Dante-B-777/LitterBot/docs/superpowers/plans/2026-04-07-sensor-ui.md

# Sensor UI Integration Implementation Plan

> **For agentic workers:** REQUIRED SUB-SKILL: Use superpowers:subagent-driven-development (recommended) or superpowers:executing-plans to implement this plan task-by-task. Steps use checkbox (`- [ ]`) syntax for tracking.

**Goal:** Wire RPLidar `/scan` and RealSense `/camera/color/image_raw` into the existing UI — live camera feed in `camera-panel`, status dots for both sensors, and scan metadata in `lidar-panel`.

**Architecture:** Subscribe to `/scan` and `/camera/color/image_raw` in `ui_server.py` (the existing ROS2 node that already bridges topics to the browser WebSocket). Add two new WebSocket message types: `sensor_status` (for lidar heartbeat + scan stats) and `cam_frame` (base64-JPEG camera frame). The frontend handles both types to update status dots and panels. No new ROS2 nodes needed — this is additive to `ui_server.py`.

**Tech Stack:** Python `sensor_msgs/LaserScan`, `sensor_msgs/Image`, Pillow (PIL) for JPEG encoding, numpy for image array conversion, existing FastAPI/WebSocket infrastructure, rplidar_ros, realsense2_camera.

> **Scope note:** LiDAR (Tasks 1–3) and Camera (Tasks 4–6) are fully independent. Either section can be executed alone without the other.

---

## File Map

| File | Action | Responsibility |
|---|---|---|
| `ros2/litterbot_bridge/litterbot_bridge/ui_server.py` | Modify | Add `/scan` + `/camera/color/image_raw` subscribers, throttled broadcasts, `_encode_image()` + `_summarize_scan()` helpers |
| `ros2/litterbot_bridge/litterbot_bridge/ui/index.html` | Modify | Handle `sensor_status` + `cam_frame` WS messages; update `updateDots()`; populate `lidar-panel` + `camera-panel` |
| `ros2/litterbot_bridge/launch/litterbot.launch.py` | Modify | Add rplidar_ros + realsense2_camera nodes behind `mock_lidar` / `mock_camera` flags |
| `ros2/litterbot_bridge/requirements.txt` | Modify | Add `Pillow>=9.0.0` and `numpy>=1.21.0` |
| `ros2/litterbot_bridge/test/test_sensor_ui.py` | Create | Unit tests for `_summarize_scan` and `_encode_image` helpers |

---

## WebSocket Protocol Additions

```
Server -> Browser (lidar heartbeat, ~1 Hz):
  {"type": "sensor_status", "sensor": "lidar", "ts": 1234.56,
   "count": 360, "range_min": 0.15, "range_max": 3.4}

Server -> Browser (camera frame, ~10 fps):
  {"type": "cam_frame", "data": "<base64_jpeg>", "ts": 1234.56}
```

---

## Task 1: Add `_summarize_scan` helper and `/scan` subscriber

**Files:**
- Modify: `ros2/litterbot_bridge/litterbot_bridge/ui_server.py`
- Create: `ros2/litterbot_bridge/test/test_sensor_ui.py`

- [ ] **Step 1: Write the failing test**

```python
# ros2/litterbot_bridge/test/test_sensor_ui.py
"""
test_sensor_ui.py — Pure logic tests for sensor UI helpers in ui_server.

No ROS2 runtime needed — tests the static helper methods directly.

Run with:
    pytest test/test_sensor_ui.py -v
"""
import sys, os
sys.path.insert(0, os.path.join(os.path.dirname(__file__), '..'))

from unittest.mock import MagicMock

# ---------------------------------------------------------------------------
# _summarize_scan tests
# ---------------------------------------------------------------------------

def _make_scan(ranges, range_min=0.15, range_max=12.0):
    """Build a minimal mock LaserScan for testing."""
    msg = MagicMock()
    import math
    msg.ranges = [r for r in ranges]  # list of floats
    msg.range_min = range_min
    msg.range_max = range_max
    return msg

def test_summarize_scan_valid_count():
    """Valid ranges within [range_min, range_max] are counted correctly."""
    from litterbot_bridge.ui_server import UIServer
    msg = _make_scan([0.5, 1.0, 12.0, float('inf'), 0.1])  # 0.1 < range_min, inf invalid
    result = UIServer._summarize_scan(msg)
    assert result['count'] == 3, f"Expected 3 valid ranges, got {result['count']}"

def test_summarize_scan_min_max():
    """Reported min/max reflect only valid readings."""
    from litterbot_bridge.ui_server import UIServer
    msg = _make_scan([1.0, 3.5, float('inf'), 0.1])
    result = UIServer._summarize_scan(msg)
    assert abs(result['range_min'] - 1.0) < 0.001
    assert abs(result['range_max'] - 3.5) < 0.001

def test_summarize_scan_all_invalid():
    """All-invalid scan returns zeros without crashing."""
    from litterbot_bridge.ui_server import UIServer
    msg = _make_scan([float('inf'), float('nan')])
    result = UIServer._summarize_scan(msg)
    assert result['count'] == 0
    assert result['range_min'] == 0.0
    assert result['range_max'] == 0.0
```

- [ ] **Step 2: Run test to verify it fails**

```bash
cd /mnt/c/Users/benji/Documents/GitHub/LitterBot_STM32/ros2/litterbot_bridge
python3 -m pytest test/test_sensor_ui.py -v
```

Expected: `ImportError` or `AttributeError` — `UIServer` has no `_summarize_scan`.

- [ ] **Step 3: Add `_summarize_scan` to `ui_server.py`**

Add this import at the top of `ui_server.py` with the other imports:
```python
import math
from sensor_msgs.msg import Image, LaserScan
```

Add this static method to the `UIServer` class (after `_on_odom`, before the asyncio helpers):
```python
    @staticmethod
    def _summarize_scan(msg: LaserScan) -> dict:
        """Extract valid range stats from a LaserScan message."""
        valid = [r for r in msg.ranges
                 if math.isfinite(r) and msg.range_min <= r <= msg.range_max]
        return {
            'count':     len(valid),
            'range_min': round(min(valid), 3) if valid else 0.0,
            'range_max': round(max(valid), 3) if valid else 0.0,
        }
```

- [ ] **Step 4: Run tests to verify they pass**

```bash
cd /mnt/c/Users/benji/Documents/GitHub/LitterBot_STM32/ros2/litterbot_bridge
python3 -m pytest test/test_sensor_ui.py::test_summarize_scan_valid_count test/test_sensor_ui.py::test_summarize_scan_min_max test/test_sensor_ui.py::test_summarize_scan_all_invalid -v
```

Expected: 3 PASS.

- [ ] **Step 5: Add `_last_scan_time`, `_last_scan_broadcast`, and `/scan` subscriber to `UIServer.__init__`**

In `UIServer.__init__`, after the `self._dev_mode` line (around line 145), add:
```python
        # ------------------------------------------------------------------ #
        # Sensor status tracking
        # ------------------------------------------------------------------ #
        self._last_scan_time: float = 0.0       # time of last /scan message
        self._last_scan_broadcast: float = 0.0  # time of last WS broadcast
        self._last_cam_time: float = 0.0        # time of last image message
        self._last_cam_broadcast: float = 0.0   # time of last cam_frame WS broadcast
```

At the end of the subscribers block (after the `/odom` subscription), add:
```python
        self.create_subscription(LaserScan, '/scan',                     self._on_scan,  10)
```

- [ ] **Step 6: Add `_on_scan` callback**

Add this method to `UIServer` after `_on_odom`:
```python
    def _on_scan(self, msg: LaserScan) -> None:
        """Track LiDAR heartbeat and broadcast scan stats at ~1 Hz."""
        now = time.time()
        self._last_scan_time = now
        # Throttle WebSocket broadcasts to 1 Hz
        if now - self._last_scan_broadcast < 1.0:
            return
        self._last_scan_broadcast = now
        stats = self._summarize_scan(msg)
        payload = {
            "type":      "sensor_status",
            "sensor":    "lidar",
            "ts":        now,
            "count":     stats['count'],
            "range_min": stats['range_min'],
            "range_max": stats['range_max'],
        }
        self._loop.call_soon_threadsafe(self._broadcast_dict_sync, payload)
```

- [ ] **Step 7: Commit**

```bash
cd /mnt/c/Users/benji/Documents/GitHub/LitterBot_STM32
git add ros2/litterbot_bridge/litterbot_bridge/ui_server.py \
        ros2/litterbot_bridge/test/test_sensor_ui.py
git commit -m "feat: add _summarize_scan helper and /scan subscriber to ui_server"
```

---

## Task 2: Wire lidar status dot and panel in `index.html`

**Files:**
- Modify: `ros2/litterbot_bridge/litterbot_bridge/ui/index.html`

- [ ] **Step 1: Add `lastScanTime` tracking to the `ws.onmessage` handler**

In `index.html`, find the `ws.onmessage` handler. It currently has an `if (data.type === 'log')` block and an `if (data.type === 'state')` block. After the existing blocks, add:

```javascript
        if (data.type === 'sensor_status' && data.sensor === 'lidar') {
          lastScanTime = data.ts;
          const panel = document.getElementById('lidar-panel');
          if (panel) {
            panel.textContent =
              `LiDAR — ${data.count} pts | ${data.range_min}m – ${data.range_max}m`;
          }
        }
```

- [ ] **Step 2: Update `updateDots()` for `dot-lidar`**

Find line:
```javascript
  setDot('dot-lidar', null);  // not connected yet — wired up when rplidar_ros is added
```

Replace with:
```javascript
  const scanAge = now - lastScanTime;
  setDot('dot-lidar', lastScanTime === 0 ? null :
                      scanAge < 5  ? 'green' :
                      scanAge < 30 ? 'yellow' : 'red');
```

- [ ] **Step 3: Update `lidar-panel` CSS to allow text**

Find in the CSS:
```css
  #lidar-panel {
    flex: 1;
    display: flex;
    align-items: center;
    justify-content: center;
    background: #111;
    border-bottom: 1px solid #2a2a2a;
    color: #333;
    font-size: 13px;
    letter-spacing: 0.05em;
  }
```

Change `color: #333;` to `color: #aaa;` so the text is visible when connected:
```css
  #lidar-panel {
    flex: 1;
    display: flex;
    align-items: center;
    justify-content: center;
    background: #111;
    border-bottom: 1px solid #2a2a2a;
    color: #aaa;
    font-size: 13px;
    letter-spacing: 0.05em;
  }
```

- [ ] **Step 4: Verify manually**

Start the ROS2 stack in mock mode:
```bash
cd ~/litterbot_ws && source install/setup.bash
ros2 launch litterbot_bridge litterbot.launch.py
```

Open `http://localhost:8765`. The `dot-lidar` should remain gray (no scan data in mock mode). That is correct behavior.

To verify the dot goes green: in a second terminal, publish a fake scan:
```bash
source ~/litterbot_ws/install/setup.bash
ros2 topic pub --once /scan sensor_msgs/msg/LaserScan \
  '{header: {frame_id: "laser"}, range_min: 0.15, range_max: 12.0,
    angle_min: -3.14, angle_max: 3.14, angle_increment: 0.017,
    ranges: [1.0, 2.0, 3.0, 1.5, 0.5]}'
```

`dot-lidar` should turn green and `lidar-panel` should update.

- [ ] **Step 5: Commit**

```bash
cd /mnt/c/Users/benji/Documents/GitHub/LitterBot_STM32
git add ros2/litterbot_bridge/litterbot_bridge/ui/index.html
git commit -m "feat: wire dot-lidar and lidar-panel to /scan sensor_status messages"
```

---

## Task 3: Add rplidar_ros to launch file

**Files:**
- Modify: `ros2/litterbot_bridge/launch/litterbot.launch.py`

- [ ] **Step 1: Update launch file**

Replace the entire contents of `launch/litterbot.launch.py` with:

```python
"""
litterbot.launch.py — Start all LitterBot ROS2 nodes with one command.

Usage:
    ros2 launch litterbot_bridge litterbot.launch.py

    # Real hardware:
    ros2 launch litterbot_bridge litterbot.launch.py mock_serial:=false serial_port:=/dev/ttyACM0

    # With LiDAR:
    ros2 launch litterbot_bridge litterbot.launch.py mock_lidar:=false lidar_port:=/dev/ttyUSB0

    # With camera:
    ros2 launch litterbot_bridge litterbot.launch.py mock_camera:=false
"""
from launch import LaunchDescription
from launch.actions import DeclareLaunchArgument
from launch.conditions import UnlessCondition
from launch.substitutions import LaunchConfiguration
from launch_ros.actions import Node

def generate_launch_description() -> LaunchDescription:
    return LaunchDescription([
        DeclareLaunchArgument('serial_port',  default_value='/dev/ttyACM0'),
        DeclareLaunchArgument('mock_serial',  default_value='true'),
        DeclareLaunchArgument('ui_port',      default_value='8765'),
        DeclareLaunchArgument('mock_lidar',   default_value='true'),
        DeclareLaunchArgument('lidar_port',   default_value='/dev/ttyUSB0'),
        DeclareLaunchArgument('mock_camera',  default_value='true'),

        Node(
            package='litterbot_bridge',
            executable='stm32_bridge',
            name='stm32_bridge',
            parameters=[{
                'serial_port': LaunchConfiguration('serial_port'),
                'mock_serial':  LaunchConfiguration('mock_serial'),
            }],
            output='screen',
        ),

        Node(
            package='litterbot_bridge',
            executable='ui_server',
            name='ui_server',
            parameters=[{
                'port': LaunchConfiguration('ui_port'),
            }],
            output='screen',
        ),

        # RPLidar — only started when mock_lidar:=false
        Node(
            package='rplidar_ros',
            executable='rplidar_composition',
            name='rplidar',
            parameters=[{
                'serial_port':     LaunchConfiguration('lidar_port'),
                'serial_baudrate': 115200,
                'frame_id':        'laser',
                'angle_compensate': True,
            }],
            output='screen',
            condition=UnlessCondition(LaunchConfiguration('mock_lidar')),
        ),

        # RealSense — only started when mock_camera:=false
        Node(
            package='realsense2_camera',
            executable='realsense2_camera_node',
            name='camera',
            parameters=[{
                'enable_color': True,
                'enable_depth': False,
                'color_width':  640,
                'color_height': 480,
                'color_fps':    15,
            }],
            output='screen',
            condition=UnlessCondition(LaunchConfiguration('mock_camera')),
        ),
    ])
```

- [ ] **Step 2: Verify launch file still works in mock mode**

```bash
cd ~/litterbot_ws && colcon build --packages-select litterbot_bridge && source install/setup.bash
ros2 launch litterbot_bridge litterbot.launch.py
```

Expected: starts without error, `stm32_bridge` and `ui_server` nodes appear. rplidar and camera nodes do NOT start (mock mode).

- [ ] **Step 3: Commit**

```bash
cd /mnt/c/Users/benji/Documents/GitHub/LitterBot_STM32
git add ros2/litterbot_bridge/launch/litterbot.launch.py
git commit -m "feat: add rplidar_ros and realsense2_camera to launch file behind mock flags"
```

---

## Task 4: Add `_encode_image` helper and `/camera/color/image_raw` subscriber

**Files:**
- Modify: `ros2/litterbot_bridge/litterbot_bridge/ui_server.py`
- Modify: `ros2/litterbot_bridge/requirements.txt`
- Modify: `ros2/litterbot_bridge/test/test_sensor_ui.py`

- [ ] **Step 1: Add Pillow + numpy to requirements.txt**

Replace the entire file:
```
fastapi>=0.110.0
uvicorn[standard]>=0.29.0
Pillow>=9.0.0
numpy>=1.21.0
```

Install:
```bash
pip install Pillow numpy
```

- [ ] **Step 2: Write the failing test**

Add to `test/test_sensor_ui.py`:

```python
# ---------------------------------------------------------------------------
# _encode_image tests
# ---------------------------------------------------------------------------

def _make_image_msg(width=4, height=4, encoding='rgb8'):
    """Build a minimal mock sensor_msgs/Image for testing."""
    import numpy as np
    msg = MagicMock()
    msg.width    = width
    msg.height   = height
    msg.encoding = encoding
    msg.step     = width * 3
    # Flat RGB bytes: 4x4 solid red image
    arr = np.zeros((height, width, 3), dtype=np.uint8)
    arr[:, :, 0] = 255  # red channel
    msg.data = arr.tobytes()
    return msg

def test_encode_image_returns_string():
    """_encode_image returns a non-empty base64 string for valid rgb8 input."""
    from litterbot_bridge.ui_server import UIServer
    msg = _make_image_msg(encoding='rgb8')
    result = UIServer._encode_image(msg)
    assert isinstance(result, str)
    assert len(result) > 0

def test_encode_image_is_valid_base64():
    """Output is valid base64 that decodes without error."""
    import base64
    from litterbot_bridge.ui_server import UIServer
    msg = _make_image_msg(encoding='rgb8')
    result = UIServer._encode_image(msg)
    decoded = base64.b64decode(result)  # raises on bad base64
    assert len(decoded) > 0

def test_encode_image_bgr8_does_not_crash():
    """bgr8 encoding is accepted (channels swapped before JPEG encode)."""
    from litterbot_bridge.ui_server import UIServer
    msg = _make_image_msg(encoding='bgr8')
    result = UIServer._encode_image(msg)
    assert isinstance(result, str) and len(result) > 0

def test_encode_image_unknown_encoding_returns_none():
    """Unsupported encoding returns None without raising."""
    from litterbot_bridge.ui_server import UIServer
    msg = _make_image_msg(encoding='yuv422')
    result = UIServer._encode_image(msg)
    assert result is None
```

- [ ] **Step 3: Run tests to verify they fail**

```bash
cd /mnt/c/Users/benji/Documents/GitHub/LitterBot_STM32/ros2/litterbot_bridge
python3 -m pytest test/test_sensor_ui.py -k "encode_image" -v
```

Expected: `AttributeError` — `UIServer` has no `_encode_image`.

- [ ] **Step 4: Add `_encode_image` to `ui_server.py`**

Add these imports at the top of `ui_server.py` with the existing imports:
```python
import base64
import io

import numpy as np
from PIL import Image as PILImage
from sensor_msgs.msg import Image, LaserScan
```

Add this static method to `UIServer` (after `_summarize_scan`):
```python
    @staticmethod
    def _encode_image(msg: Image) -> str | None:
        """
        Convert a sensor_msgs/Image to a base64-encoded JPEG string.

        Supports rgb8 and bgr8 encodings. Returns None for unsupported encodings.
        """
        if msg.encoding not in ('rgb8', 'bgr8'):
            return None
        try:
            arr = np.frombuffer(bytes(msg.data), dtype=np.uint8).reshape(
                msg.height, msg.width, 3
            )
            if msg.encoding == 'bgr8':
                arr = arr[:, :, ::-1]  # BGR -> RGB
            buf = io.BytesIO()
            PILImage.fromarray(arr, 'RGB').save(buf, format='JPEG', quality=70)
            return base64.b64encode(buf.getvalue()).decode('ascii')
        except Exception:
            return None
```

- [ ] **Step 5: Run tests to verify they pass**

```bash
cd /mnt/c/Users/benji/Documents/GitHub/LitterBot_STM32/ros2/litterbot_bridge
python3 -m pytest test/test_sensor_ui.py -k "encode_image" -v
```

Expected: 4 PASS.

- [ ] **Step 6: Add `/camera/color/image_raw` subscriber to `UIServer.__init__`**

After the `/scan` subscription line, add:
```python
        self.create_subscription(Image,     '/camera/color/image_raw', self._on_image, 1)
```

Note: queue depth 1 — we don't want a backlog of frames; always process the latest.

- [ ] **Step 7: Add `_on_image` callback**

Add after `_on_scan`:
```python
    def _on_image(self, msg: Image) -> None:
        """Convert incoming camera frame to JPEG and broadcast at ~10 fps."""
        now = time.time()
        self._last_cam_time = now
        # Throttle to ~10 fps
        if now - self._last_cam_broadcast < 0.1:
            return
        self._last_cam_broadcast = now
        frame_b64 = self._encode_image(msg)
        if frame_b64 is None:
            return
        payload = {
            "type": "cam_frame",
            "data": frame_b64,
            "ts":   now,
        }
        self._loop.call_soon_threadsafe(self._broadcast_dict_sync, payload)
```

- [ ] **Step 8: Run all sensor tests**

```bash
cd /mnt/c/Users/benji/Documents/GitHub/LitterBot_STM32/ros2/litterbot_bridge
python3 -m pytest test/test_sensor_ui.py -v
```

Expected: all 7 tests PASS.

- [ ] **Step 9: Commit**

```bash
cd /mnt/c/Users/benji/Documents/GitHub/LitterBot_STM32
git add ros2/litterbot_bridge/litterbot_bridge/ui_server.py \
        ros2/litterbot_bridge/requirements.txt \
        ros2/litterbot_bridge/test/test_sensor_ui.py
git commit -m "feat: add _encode_image helper and /camera/color/image_raw subscriber"
```

---

## Task 5: Wire camera display in `index.html`

**Files:**
- Modify: `ros2/litterbot_bridge/litterbot_bridge/ui/index.html`

- [ ] **Step 1: Add `lastCamTime` variable**

Find the existing sensor time variables near line 686:
```javascript
let lastStm32TxTime = 0;
let lastOdomTime    = 0;
let lastScanTime    = 0;  // populated when /scan topic is wired up
```

Add:
```javascript
let lastStm32TxTime = 0;
let lastOdomTime    = 0;
let lastScanTime    = 0;
let lastCamTime     = 0;
```

- [ ] **Step 2: Replace `camera-panel` placeholder with an `<img>` tag**

Find:
```html
    <div id="camera-panel">[ Camera — not yet connected ]</div>
```

Replace with:
```html
    <div id="camera-panel">
      <img id="cam-img" src="" alt="" style="width:100%;height:100%;object-fit:contain;display:none;">
      <span id="cam-placeholder">[ Camera — not yet connected ]</span>
    </div>
```

- [ ] **Step 3: Add `cam_frame` handler to `ws.onmessage`**

After the `sensor_status` lidar block added in Task 2, add:
```javascript
        if (data.type === 'cam_frame') {
          lastCamTime = data.ts;
          const img = document.getElementById('cam-img');
          const placeholder = document.getElementById('cam-placeholder');
          if (img) {
            img.src = 'data:image/jpeg;base64,' + data.data;
            img.style.display = 'block';
          }
          if (placeholder) placeholder.style.display = 'none';
        }
```

- [ ] **Step 4: Update `updateDots()` for `dot-cam`**

Find:
```javascript
  setDot('dot-cam',   null);  // not connected yet
```

Replace with:
```javascript
  const camAge = now - lastCamTime;
  setDot('dot-cam', lastCamTime === 0 ? null :
                    camAge < 5  ? 'green' :
                    camAge < 30 ? 'yellow' : 'red');
```

- [ ] **Step 5: Style the camera panel to show the image properly**

Find the `#camera-panel` CSS block:
```css
  #camera-panel {
```

Add a rule to make text centered when showing placeholder:
```css
  #camera-panel {
    flex: 1;
    display: flex;
    align-items: center;
    justify-content: center;
    background: #000;
    overflow: hidden;
  }
  #cam-placeholder {
    color: #333;
    font-size: 13px;
    letter-spacing: 0.05em;
  }
```

(Replace the existing `#camera-panel` block, which likely already has similar content — check the current CSS and replace whatever is there.)

- [ ] **Step 6: Verify manually in mock mode**

```bash
ros2 launch litterbot_bridge litterbot.launch.py
```

Open `http://localhost:8765`. Camera panel should show `[ Camera — not yet connected ]` and `dot-cam` should be gray. That is correct.

To verify the frame display: publish a synthetic image message:
```bash
source ~/litterbot_ws/install/setup.bash
ros2 topic pub --rate 5 /camera/color/image_raw sensor_msgs/msg/Image \
  '{header: {frame_id: "camera_color_optical_frame"},
    height: 4, width: 4, encoding: "rgb8", step: 12,
    data: [255,0,0, 0,255,0, 0,0,255, 255,255,0,
           255,0,0, 0,255,0, 0,0,255, 255,255,0,
           255,0,0, 0,255,0, 0,0,255, 255,255,0,
           255,0,0, 0,255,0, 0,0,255, 255,255,0]}'
```

`dot-cam` should turn green and `camera-panel` should show a small colorful image.

- [ ] **Step 7: Commit**

```bash
cd /mnt/c/Users/benji/Documents/GitHub/LitterBot_STM32
git add ros2/litterbot_bridge/litterbot_bridge/ui/index.html
git commit -m "feat: add live camera feed to camera-panel with dot-cam status wiring"
```

---

## Task 6: Run full test suite and verify nothing is broken

**Files:** No changes — verification only.

- [ ] **Step 1: Run all tests**

```bash
cd /mnt/c/Users/benji/Documents/GitHub/LitterBot_STM32/ros2/litterbot_bridge
python3 -m pytest test/ -v --ignore=test/test_firmware_spec.py
```

Expected: all tests pass. `test_firmware_spec.py` is excluded because it requires hardware (`--serial-port` flag).

- [ ] **Step 2: Build the package**

```bash
cd ~/litterbot_ws && colcon build --packages-select litterbot_bridge && source install/setup.bash
```

Expected: build succeeds with no errors.

- [ ] **Step 3: Smoke test the full launch**

```bash
ros2 launch litterbot_bridge litterbot.launch.py
```

Open `http://localhost:8765`. Verify:
- Status bar shows all existing dots (WS green, others gray/colored as before)
- `dot-cam` and `dot-lidar` are gray (no hardware in mock mode)
- Teleop still works (WASD keys visible, deploy overlay present)
- No console errors in browser devtools

- [ ] **Step 4: Final commit**

```bash
cd /mnt/c/Users/benji/Documents/GitHub/LitterBot_STM32
git add .
git commit -m "feat: sensor UI integration complete — lidar status dot + camera feed wired up"
```

---

## Hardware Bringup Notes (for when sensors are physically connected)

**RPLidar (USB serial):**
```bash
# Find port
ls /dev/ttyUSB*
# Launch with real lidar
ros2 launch litterbot_bridge litterbot.launch.py mock_lidar:=false lidar_port:=/dev/ttyUSB0
```

Install if not present: `sudo apt install ros-humble-rplidar-ros`

**RealSense (USB3):**
```bash
# Launch with real camera
ros2 launch litterbot_bridge litterbot.launch.py mock_camera:=false
```

Install if not present: `sudo apt install ros-humble-realsense2-camera`

Check the RealSense is seen by the system:
```bash
realsense-viewer  # or
rs-enumerate-devices
```

**Combined real hardware launch:**
```bash
ros2 launch litterbot_bridge litterbot.launch.py \
  mock_serial:=false serial_port:=/dev/ttyACM0 \
  mock_lidar:=false lidar_port:=/dev/ttyUSB0 \
  mock_camera:=false
```
