Dante-B-777/LitterBot/Litterbot_Obsidian/Resources/Datasheets.md

# Datasheets

## STM32

`docs/datasheets/STM32L4A6ZG Nucleo/STM32L4A6ZG Datasheet.pdf`
`docs/datasheets/STM32L4A6ZG Nucleo/Nucleo-144 User Manual.pdf`

## DC Motors

`docs/datasheets/Planetary Gear Motor Spec Sheet.pdf`
`docs/datasheets/Planetary Gear Motor Driver Datasheet.pdf`

## Stepper Motor

`docs/datasheets/Stepper Motor/23HS45-4204D-E1000_Full_Datasheet.pdf`
`docs/datasheets/Stepper Motor/CL57T-V41_Manual.pdf`
`docs/datasheets/Stepper Motor Driver.pdf`

## Bus Servo

`docs/datasheets/Servo Motor/HX-65HM Bus Servo User Manual.pdf`
`docs/datasheets/Servo Motor/HX-65 Servo Manual.pdf`

## Jetson

`docs/datasheets/jetson-orin-datasheet-nano-developer-kit-3575392-r2.pdf`

## Chassis

`docs/datasheets/Chasis Assembly Manual.pdf`
`docs/datasheets/Chasis Pictures.pdf`
