Dante-B-777/LitterBot/tools/Run1/motor_comparison_20260409_140856.png

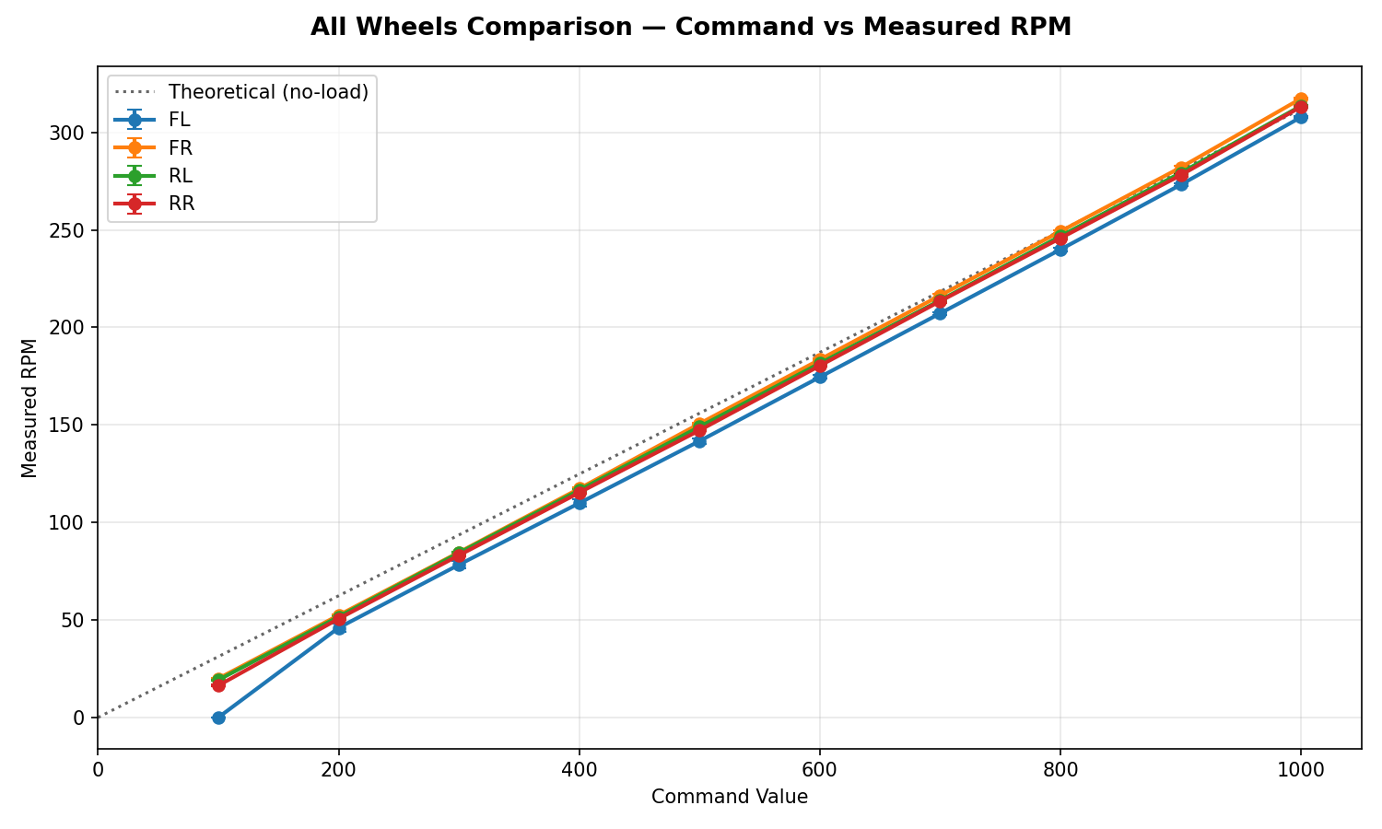
tools/Run1/motor_comparison_20260409_140856.png
