Dante-B-777/LitterBot/tools/motor_characterization_20260409_140856.csv

command | direction | fl_rpm | fr_rpm | rl_rpm | rr_rpm | fl_std | fr_std | rl_std | rr_std
100 | FWD | 0.00 | 19.95 | 19.21 | 16.36 | 0.00 | 0.37 | 0.35 | 0.53
200 | FWD | 45.98 | 52.42 | 51.67 | 50.62 | 2.07 | 0.29 | 0.27 | 0.47
300 | FWD | 78.31 | 84.69 | 84.38 | 83.14 | 1.92 | 0.25 | 0.38 | 0.41
400 | FWD | 109.91 | 117.35 | 116.54 | 115.30 | 1.76 | 0.48 | 0.44 | 0.54
500 | FWD | 141.75 | 150.67 | 149.06 | 147.26 | 1.41 | 0.57 | 0.38 | 0.56
600 | FWD | 174.55 | 183.53 | 181.61 | 180.37 | 0.88 | 0.51 | 0.42 | 0.40
700 | FWD | 207.22 | 216.39 | 213.91 | 213.47 | 0.71 | 0.98 | 0.76 | 0.85
800 | FWD | 239.96 | 249.25 | 246.84 | 245.78 | 0.86 | 0.63 | 0.76 | 0.72
900 | FWD | 273.20 | 282.05 | 279.27 | 278.09 | 0.94 | 0.85 | 0.77 | 0.71
1000 | FWD | 307.85 | 317.39 | 313.61 | 313.18 | 0.60 | 0.60 | 0.58 | 0.58
