Dante-B-777/LitterBot/firmware/stm32/LitterBot/Core/Src/main.c

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
/* Includes ------------------------------------------------------------------*/
#include "main.h"

/* USEIncludes */

  // #include "servo_test.h"
  // #include "dc_motor_test.h"
  // #include "stepper_test.h"
  // #include "combined_test.h"
  #include "encoder.h"
  #include "odometry.h"
  #include "uart_cmd.h"
  #include "calibration_store.h"
  // #include "encoder_test.h"

UART_HandleTypeDef hlpuart1;
UART_HandleTypeDef huart3;

TIM_HandleTypeDef htim1;
TIM_HandleTypeDef htim2;
TIM_HandleTypeDef htim3;
TIM_HandleTypeDef htim4;
TIM_HandleTypeDef htim8;

PCD_HandleTypeDef hpcd_USB_OTG_FS;

/* USER CODE BEGIN PV */
static uint8_t rx_byte;
/* USER CODE END PV */

void SystemClock_Config(void);
static void MX_GPIO_Init(void);
static void MX_LPUART1_UART_Init(void);
static void MX_USB_OTG_FS_PCD_Init(void);
static void MX_TIM2_Init(void);
static void MX_USART3_UART_Init(void);
static void MX_TIM1_Init(void);
static void MX_TIM3_Init(void);
static void MX_TIM4_Init(void);
static void MX_TIM8_Init(void);
/**
  * @brief  The application entry point.
  * @retval int
  */
int main(void)
{

  /* MCU Configuration--------------------------------------------------------*/

  /* Reset of all peripherals, Initializes the Flash interface and the Systick. */
  HAL_Init();

  /* Configure the system clock */
  SystemClock_Config();

  /* Initialize all configured peripherals */
  MX_GPIO_Init();
  MX_LPUART1_UART_Init();
  MX_USB_OTG_FS_PCD_Init();
  MX_TIM2_Init();
  MX_USART3_UART_Init();
  MX_TIM1_Init();
  MX_TIM3_Init();
  MX_TIM4_Init();
  MX_TIM8_Init();
  /* USER CODE BEGIN 2 */
  // ServoTest_Init(&huart3);
  // DCMotorTest_Init();
  // StepperTest_Init();
  // CombinedTest_Init(&huart3);

  /* Match LitterBot_v2_workspace_1.18.0: 300 ms settle after USART3 init
   * before the first servo packet. v2's working main() has this exact
   * delay between MX_USART3_UART_Init() and the first hx65_write_pos(). */
  HAL_Delay(300);

  Encoder_Init();
  Odometry_Init();
  CalStore_Init();
  UartCmd_Init(&hlpuart1);
  HAL_UART_Receive_IT(&hlpuart1, &rx_byte, 1);

  // --- Encoder test standalone (B1 button only, no teleop) ---
  // EncoderTest_Init(&hlpuart1);
  /* USER CODE END 2 */

  /* Infinite loop */
  /* USER CODE BEGIN WHILE */
  while (1)
  {
    /* USER CODE END WHILE */

    /* USER CODE BEGIN 3 */
    // ServoTest_Poll();
    // DCMotorTest_Poll();
    // StepperTest_Poll();
    // CombinedTest_Poll();

    // --- UART teleop + encoder telemetry (ROS2 mode) ---
    Encoder_Update();
    Odometry_Update();
    UartCmd_Task(HAL_GetTick());
    UartCmd_TelemetryTask(HAL_GetTick());

    /* Heartbeat: LD3 (PB14) blinks at ~1 Hz to confirm firmware is alive */
    static uint32_t last_hb = 0;
    uint32_t now = HAL_GetTick();
    if (now - last_hb >= 500) {
        HAL_GPIO_TogglePin(LD3_GPIO_Port, LD3_Pin);
        last_hb = now;
    }
  }
  /* USER CODE END 3 */
}

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
/* USER CODE BEGIN 4 */

void HAL_UART_RxCpltCallback(UART_HandleTypeDef *huart) {
  if (huart->Instance == LPUART1) {
    UartCmd_OnRxByte(rx_byte);
    HAL_UART_Receive_IT(&hlpuart1, &rx_byte, 1);
  }
}

void HAL_UART_ErrorCallback(UART_HandleTypeDef *huart) {
  /* Re-arm the interrupt after any error (framing, overrun, noise).
   * Clear sticky error flags first — overrun (ORE) in particular will
   * immediately re-trigger the error if left set, causing an interrupt storm. */
  if (huart->Instance == LPUART1) {
    __HAL_UART_CLEAR_FLAG(huart, UART_CLEAR_OREF | UART_CLEAR_NEF |
                                  UART_CLEAR_PEF  | UART_CLEAR_FEF);
    __HAL_UART_FLUSH_DRREGISTER(huart);
    HAL_UART_Receive_IT(&hlpuart1, &rx_byte, 1);
  }
}

/* USER CODE END 4 */
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
