Dante-B-777/LitterBot/firmware/stm32/LitterBot/LitterBot.ioc

Mcu.UserName=STM32L4A6ZGTx
PA0.Signal=S_TIM2_CH1
PA1.Signal=S_TIM2_CH2
PA10.GPIO_Label=USB_ID
PA10.Signal=USB_OTG_FS_ID
PA11.GPIO_Label=USB_DM
PA11.Signal=USB_OTG_FS_DM
PA12.GPIO_Label=USB_DP
PA12.Signal=USB_OTG_FS_DP
PA2.Signal=S_TIM2_CH3
PA3.Signal=S_TIM2_CH4
PA8.GPIO_Label=USB_SOF [TP1]
PA8.Signal=USB_OTG_FS_SOF
PA9.GPIO_Label=USB_VBUS
PA9.Signal=USB_OTG_FS_VBUS
PB14.GPIO_Label=LD3 [Red]
PB14.Signal=GPIO_Output
PB6.Signal=S_TIM4_CH1
PB7.Signal=S_TIM4_CH2
PC10.Signal=USART3_TX
PC13.GPIO_Label=B1
PC13.Signal=GPXTI13
PC6.Signal=S_TIM8_CH1
PC7.Signal=S_TIM8_CH2
PE11.Signal=S_TIM1_CH2
PE3.Signal=S_TIM3_CH1
PE4.Signal=S_TIM3_CH2
PE9.Signal=S_TIM1_CH1
PG5.GPIO_Label=USB_OverCurrent [STMPS2151STR_FAULT]
PG5.Signal=GPIO_Input
PG6.GPIO_Label=USB_PowerSwitchOn [STMPS2151STR_EN]
PG6.Signal=GPIO_Output
PG7.GPIO_Label=STLK_RX [STM32F103CBT6_PA3]
PG7.Signal=LPUART1_TX
PG8.GPIO_Label=STLK_TX [STM32F103CBT6_PA2]
PG8.Signal=LPUART1_RX
