Dante-B-777/LitterBot/ros2/litterbot_bridge/test/test_firmware_spec.py

"""
test_firmware_spec.py — STM32 Firmware Hardware Test Procedures.

ALL TESTS IN THIS FILE ARE SKIPPED BY DEFAULT.
They require the STM32 NUCLEO-144 board connected via USB-UART.

These tests document the exact procedure for verifying each firmware
module on hardware.  When you're ready to run them:

  1. Connect STM32 via USB-UART adapter to WSL2:
       usbipd attach --wsl --busid <id>   (run on Windows)

  2. Fix LPUART1 word length in CubeMX (9B -> 8B) and reflash.

  3. Run with:
       pytest test/test_firmware_spec.py -v -m hardware
         --serial-port /dev/ttyUSB0

WHY THESE TESTS EXIST
---------------------
All STM32 firmware modules were written and build cleanly but have never
been run on real hardware. These tests are the acceptance criteria for
the hardware bring-up phase. Each test documents:
  - What to observe (LED, serial output, physical movement)
  - What constitutes pass vs fail
  - Which firmware module is under test
"""
import pytest
import time

# ---------------------------------------------------------------------------
# Hardware fixture — skipped unless --serial-port is provided
# ---------------------------------------------------------------------------

@pytest.fixture(scope='module')
def serial_port(request):
    port = request.config.getoption('--serial-port', skip=True)
    import serial
    ser = serial.Serial(port, 115200, timeout=2.0)
    time.sleep(0.5)  # let STM32 boot
    yield ser
    ser.close()


# ---------------------------------------------------------------------------
# UART Parser Tests
# (tests the uart_cmd.c firmware module)
# ---------------------------------------------------------------------------

class TestUartParser:
    """
    Tests for uart_cmd.c — the STM32 UART command parser.

    uart_cmd.c accepts:
      M <fl> <fr> <rl> <rr>\\n  — motor command, values -1000 to 1000
      X\\n                       — emergency stop

    WHY: If the parser is broken, the robot ignores all ROS2 commands.
    This is the most critical firmware interface to verify first.
    """

    def test_motor_command_accepted(self, serial_port):
        """
        Sending 'M 100 100 100 100\\n' is accepted and drives all motors.

        PASS: Motors audibly/visually spin (or at low duty cycle, current
              draw increases on the bench power supply).
        FAIL: No motor movement, or STM32 resets/hangs.

        Firmware module: uart_cmd.c -> uart_cmd_process()
        """
        serial_port.write(b'M 100 100 100 100\n')
        time.sleep(0.5)
        serial_port.write(b'M 0 0 0 0\n')

    def test_estop_command_stops_motors(self, serial_port):
        """
        Sending 'X\\n' immediately stops all motors.

        PASS: Motors that were running stop within one control cycle (~10ms).
        FAIL: Motors keep running after X\\n.

        This is a SAFETY-CRITICAL test. X\\n must always work.

        Firmware module: uart_cmd.c -> uart_cmd_process()
        """
        # Start motors
        serial_port.write(b'M 300 300 300 300\n')
        time.sleep(0.3)
        # Emergency stop
        serial_port.write(b'X\n')
        time.sleep(0.1)
        # Send another M command — motors should NOT respond (watchdog resets)
        serial_port.write(b'M 300 300 300 300\n')
        time.sleep(0.1)
        serial_port.write(b'M 0 0 0 0\n')

    def test_malformed_command_ignored(self, serial_port):
        """
        Malformed commands ('Z\\n', 'M\\n', random bytes) are ignored.

        PASS: No motor movement, STM32 does not reset.
        FAIL: Motors move unexpectedly, or MCU enters fault state.

        Firmware module: uart_cmd.c -> uart_cmd_process()
        """
        serial_port.write(b'Z\n')
        time.sleep(0.1)
        serial_port.write(b'M\n')         # M with no values
        time.sleep(0.1)
        serial_port.write(b'\xff\xfe\n')  # garbage bytes
        time.sleep(0.1)
        # Confirm normal command still works after garbage
        serial_port.write(b'M 50 50 50 50\n')
        time.sleep(0.2)
        serial_port.write(b'M 0 0 0 0\n')

    def test_watchdog_stops_motors_on_timeout(self, serial_port):
        """
        Motors stop automatically if no command received for >250 ms.

        PASS: Motors start, then stop on their own ~250ms after last command.
        FAIL: Motors keep running indefinitely.

        WHY: The watchdog is the last line of defence if the Jetson crashes
        or loses the serial connection mid-drive.

        Firmware module: uart_cmd.c (watchdog timer)
        """
        serial_port.write(b'M 200 200 200 200\n')
        # Do NOT send any more commands — watchdog should fire at ~250ms
        time.sleep(0.5)
        # At this point motors should be stopped
        # PASS = motors stopped. FAIL = motors still running.


# ---------------------------------------------------------------------------
# DC Motor Tests
# (tests the cytron_md10c.c firmware module)
# ---------------------------------------------------------------------------

class TestDCMotors:
    """
    Tests for cytron_md10c.c — DC motor PWM + direction control.

    These tests verify correct direction and relative speed.
    Requires motors connected to Cytron MD10C drivers.

    WHY: Incorrect DIR pin logic means the robot drives backwards when
    commanded forward, making all autonomous navigation wrong.
    """

    def test_all_wheels_forward(self, serial_port):
        """
        M 500 500 500 500\\n → all four wheels spin forward.

        PASS: All wheels spin in the same forward direction at ~50% speed.
        FAIL: Any wheel spins backward, or at noticeably different speed.

        Firmware modules: uart_cmd.c + cytron_md10c.c
        """
        serial_port.write(b'M 500 500 500 500\n')
        time.sleep(1.0)
        serial_port.write(b'X\n')

    def test_all_wheels_backward(self, serial_port):
        """
        M -500 -500 -500 -500\\n → all four wheels spin backward.

        PASS: All wheels spin in the same reverse direction.
        FAIL: Any wheel spins forward.
        """
        serial_port.write(b'M -500 -500 -500 -500\n')
        time.sleep(1.0)
        serial_port.write(b'X\n')

    def test_strafe_right_wheel_pattern(self, serial_port):
        """
        Mecanum strafe right: FL+RR forward, FR+RL backward.

        M frame for strafe right from kinematics (vy=-0.3):
          FL positive, FR negative, RL negative, RR positive

        PASS: FL and RR spin forward; FR and RL spin backward.
        FAIL: Wrong wheel directions (robot rotates instead of strafes).

        Firmware modules: uart_cmd.c + cytron_md10c.c
        """
        # Approximate strafe-right values at vy=-0.3
        serial_port.write(b'M 300 -300 -300 300\n')
        time.sleep(1.0)
        serial_port.write(b'X\n')

    def test_rotate_ccw_wheel_pattern(self, serial_port):
        """
        Counter-clockwise rotation: left wheels backward, right wheels forward.

        M frame for CCW rotation from kinematics (wz=+0.5):
          FL negative, FR positive, RL negative, RR positive

        PASS: Left side spins backward, right side spins forward.
        FAIL: Robot translates instead of rotating.
        """
        serial_port.write(b'M -300 300 -300 300\n')
        time.sleep(1.0)
        serial_port.write(b'X\n')


# ---------------------------------------------------------------------------
# Encoder Tests
# (tests the encoder.c firmware module)
# ---------------------------------------------------------------------------

class TestEncoders:
    """
    Tests for encoder.c — quadrature encoder capture via TIM1/3/4/8.

    These tests verify that spinning each wheel produces tick counts
    in the correct direction on the correct timer.

    WHY: Wrong encoder assignment means odometry maps wheel movement to
    the wrong wheel position, corrupting all position estimates.

    PROCEDURE: With motors disabled (power off or disconnected), spin
    each wheel by hand and observe serial debug output for tick counts.
    """

    def test_fl_encoder_counts_on_TIM4(self, serial_port):
        """
        Spinning the Front-Left wheel produces counts on TIM4 (PB6/PB7).

        PASS: TIM4 counter changes when FL wheel is spun by hand.
              Other timers do not change.
        FAIL: Wrong timer counts, or no counts at all.

        Firmware module: encoder.c (TIM4 encoder mode)
        Note: PB7 conflicts with LD2 LED — if counts are erratic,
              LD2 may be interfering.
        """
        pytest.skip('Manual observation required — spin FL wheel by hand '
                    'and confirm TIM4 counter changes in debug output')

    def test_fr_encoder_counts_on_TIM3(self, serial_port):
        """
        Spinning the Front-Right wheel produces counts on TIM3 (PA6/PA7).

        PASS: TIM3 counter changes when FR wheel is spun by hand.
        FAIL: Wrong timer counts, or no counts at all.
        """
        pytest.skip('Manual observation required — spin FR wheel by hand '
                    'and confirm TIM3 counter changes in debug output')

    def test_rl_encoder_counts_on_TIM8(self, serial_port):
        """
        Spinning the Rear-Left wheel produces counts on TIM8 (PC6/PC7).

        PASS: TIM8 counter changes when RL wheel is spun by hand.
        FAIL: Wrong timer counts.
        """
        pytest.skip('Manual observation required — spin RL wheel by hand '
                    'and confirm TIM8 counter changes in debug output')

    def test_rr_encoder_counts_on_TIM1(self, serial_port):
        """
        Spinning the Rear-Right wheel produces counts on TIM1 (PE9/PE11).

        PASS: TIM1 counter changes when RR wheel is spun by hand.
        FAIL: Wrong timer counts.
        """
        pytest.skip('Manual observation required — spin RR wheel by hand '
                    'and confirm TIM1 counter changes in debug output')

    def test_encoder_direction_correct(self, serial_port):
        """
        Spinning a wheel forward increments count; backward decrements.

        PASS: Count goes up for forward spin, down for reverse.
        FAIL: Directions are swapped (odometry sign would be wrong).
        """
        pytest.skip('Manual observation required — note count direction '
                    'vs physical wheel spin direction')


# ---------------------------------------------------------------------------
# Servo Tests
# (tests the hx65_servo.c firmware module)
# ---------------------------------------------------------------------------

class TestServo:
    """
    Tests for hx65_servo.c — HX-65HM bus servo via USART3.

    WHY: The servo controls scoop bucket angle. If communication fails,
    the scoop mechanism is completely non-functional.
    """

    def test_servo_responds_to_ping(self, serial_port):
        """
        STM32 can PING the servo and receive a response.

        PASS: servo_test.c PING returns a valid response packet.
              LD3 or debug UART confirms communication.
        FAIL: Timeout or no response (check wiring, baud rate, half-duplex
              direction control).

        Firmware module: hx65_servo.c -> hx65_servo_ping()
        Hardware: USART3 half-duplex on PC10
        """
        pytest.skip('Manual test: press B1 button, confirm servo responds '
                    'in debug output (servo_test.c)')

    def test_servo_sweeps_full_range(self, serial_port):
        """
        Servo moves from minimum to maximum position and back.

        PASS: Servo physically moves through its full range without
              stalling, overheating, or fault LED.
        FAIL: No movement, partial movement, or fault triggered.

        Firmware module: hx65_servo.c (servo_test.c sweep)
        """
        pytest.skip('Manual test: press B1 button, observe servo sweep '
                    'physically through full range')


# ---------------------------------------------------------------------------
# Stepper Tests
# (tests the cl57t_stepper.c firmware module)
# ---------------------------------------------------------------------------

class TestStepper:
    """
    Tests for cl57t_stepper.c — NEMA 23 closed-loop stepper via CL57T driver.

    WHY: The stepper drives the linear arm extension. If step pulses are
    wrong width or direction is wrong, the arm won't move or will move
    in the wrong direction.
    """

    def test_stepper_moves_forward(self, serial_port):
        """
        Stepper extends arm forward (positive direction).

        PASS: Arm physically moves forward (toward front of robot).
        FAIL: No movement, wrong direction, or CL57T fault LED.

        Firmware module: cl57t_stepper.c
        Hardware: PD14 (PUL+), PF15 (DIR+)
        Min pulse width: 2.5 µs
        """
        pytest.skip('Manual test: stepper_test.c — press B1, confirm arm '
                    'moves forward')

    def test_stepper_moves_backward(self, serial_port):
        """
        Stepper retracts arm backward (negative direction).

        PASS: Arm physically retracts toward robot.
        FAIL: No movement, wrong direction.
        """
        pytest.skip('Manual test: stepper_test.c phase 2 — confirm arm '
                    'retracts')

    def test_stepper_speed_variation(self, serial_port):
        """
        Stepper moves at three different speeds without losing steps.

        PASS: Arm moves smoothly at all three speeds; CL57T does not fault.
        FAIL: Stalling, missed steps, or fault LED at higher speeds.

        Firmware module: cl57t_stepper.c (stepper_test.c 3-phase sequence)
        """
        pytest.skip('Manual test: stepper_test.c 3-phase speed sequence')


# ---------------------------------------------------------------------------
# Combined Integration Test
# ---------------------------------------------------------------------------

class TestCombined:
    """
    Tests for combined_test.c — all peripherals active simultaneously.

    WHY: Individual modules may work alone but fail when all are running
    together due to timer conflicts, interrupt priority issues, or shared
    resource contention.
    """

    def test_all_peripherals_no_conflict(self, serial_port):
        """
        All peripherals (DC motors, stepper, servo, encoders) run together
        without conflict.

        PASS: combined_test.c runs all 7 phases to completion.
              No resets, fault LEDs, or missed phases.
        FAIL: Any phase hangs, MCU resets, or peripheral fails when others
              are active.

        Firmware module: combined_test.c (7-phase sequence)
        """
        pytest.skip('Manual test: press B1 with combined_test.c flashed, '
                    'observe all 7 phases complete successfully')
